xiaolongsya/pi-stm32-robot-dog/PCB_控制板pcb_2026-09-02.pdf

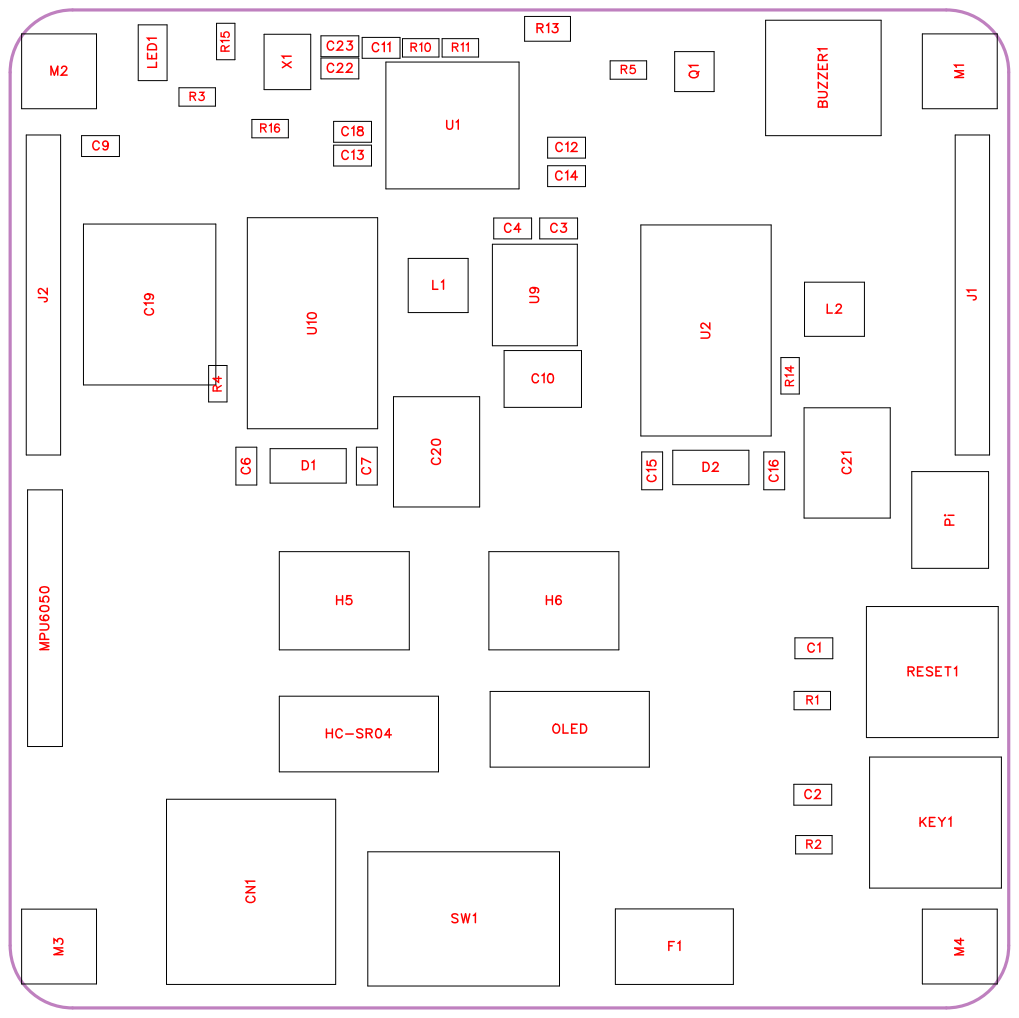
[picture p1: page 1]

No. | Quantity | Comment | Designator | Footprint | Value | Manufacturer Part | Manufacturer | Supplier Part | Supplier
1 | 1 | 2.7kHz | BUZZER1 | BUZ-TH_BD 9.0-P4.00-D0 .6-FD | 2.7kHz | QMB-09B-03 | 华能 | C96256 | LCSC
2 | 11 | 100nF | C1,C2,C6,C7,C9,C11,C12, C14,C15,C16,C18 | C0603 | 100nF | FCC0603B10 4K500CT | FOJAN(富捷) | C5137636 | LCSC
3 | 2 | 22uF | C3,C4 | C0603 | 22uF | HGC0603R5 226M100NT HJ | Chinocera(华 瓷) | C7432770 | LCSC
4 | 1 | 22uF | C10 | CAP-SMD_B D4.0-L4.3-W 4.3-FD_1 | 22uF | JVJ16V22M4 X5 | JIERR(捷而 瑞) | C46550398 | LCSC
5 | 1 | 10nF | C13 | C0603 | 10nF | FCC0603B10 3K500CT | FOJAN(富捷) | C5137477 | LCSC
6 | 1 | 470uF | C19 | CAP-SMD_B D10.0-L10.3-W10.3-LS11. 0 | 470uF | JVJ35V470M 10x10 | JIERR(捷而 瑞) | C46550413 | LCSC
7 | 2 | 220uF | C20,C21 | CAP-SMD_B D6.3-L6.6-W 6.6-LS7.3-FD | 220uF | MA25V220M 6X8 | JIERR(捷而 瑞) | C46550464 | LCSC
8 | 2 | 22pF | C22,C23 | C0603 | 22pF | CL10C220JB 8NNNC | SAMSUNG( 三星) | C1653 | LCSC
9 | 1 | XT30PW-M3 0.G.Y | CN1 | CONN-TH_X T30PW-M | | XT30PW-M3 0.G.Y | AMASS(艾迈 斯) | C431092 | LCSC
10 | 2 | SS54 | D1,D2 | SMA_L4.3-W 2.6-LS5.0-FD | | SS54 | R+O(宏嘉诚) | C7420369 | LCSC
11 | 1 | SMD2920-50 0-24 | F1 | F2920 | | SMD2920-50 0-24 | R+O(宏嘉诚) | C47753903 | LCSC
12 | 2 | 01.5.5.1.304. 03 | H5,H6 | HDR-TH_12 P-P2.54-V-M -R3-C4-S2.5 4 | | 01.5.5.1.304. 03 | RealRun(惟 赞) | C2937160 | LCSC
13 | 2 | LAIL-PHC2.5 4-4P-01-XH-L | HC-SR04,OLED | CONN-TH_L AIL-PHC2.54 -4P-01-XH-L | | LAIL-PHC2.5 4-4P-01-XH-L | 莱联 | C54905972 | LCSC
14 | 2 | 2.54-1*10P针 | J1,J2 | HDR-TH_10 P-P2.54-V-M -1 | | 2.54-1*10P针 | BOOMELE( 博穆精密) | C57369 | LCSC
15 | 2 | TS-1045AD-A8B3-D2 | KEY1,RESET1 | SW-SMD_Y UANDI_TS-1 045AD-A8B3 -D2 | | TS-1045AD-A8B3-D2 | Yuandi(元迪) | C2894745 | LCSC
16 | 2 | 3.3uH | L1,L2 | IND-SMD_L4 .0-W4.0 | 3.3uH | FHD4020S-3 R3MT | cjiang(长江微 电) | C602030 | LCSC
17 | 1 | GL0805UR0 1 | LED1 | LED0805-R-RD_RED | | GL0805UR0 1 | Guiguang lig ht(桂光光电) | C51933307 | LCSC
18 | 4 | M3螺钉孔 | M1,M2,M3,M4 | 螺钉孔
19 | 1 | 2.54-1*8 | MPU6050 | HDR-TH_8P-P2.54-V-M | | 2.54-1*8 | ZHOURI(洲 日) | C5156616 | LCSC

20 | 1 | HX 2.54mm-2P ZZ-MS | Pi | CONN-TH_2 P-P2.50_HX-2.54MM-2P-ZZ-MS | | HX 2.54mm-2P ZZ-MS | hanxia(韩下 ) | C7543455 | LCSC
21 | 1 | SS8050 | Q1 | SOT-23-3_L2 .9-W1.3-P1.9 0-LS2.4-BR | | SS8050 | R+O(宏嘉诚 ) | C7420370 | LCSC
22 | 4 | 10k | R1,R2,R10,R11 | R0603 | 10k | FRC0603J10 3 TS | FOJAN(富捷 ) | C2930027 | LCSC
23 | 4 | 1k | R3,R4,R5,R14 | R0603 | 1k | FRC0603F10 01TS | FOJAN(富捷 ) | C2907002 | LCSC
24 | 1 | 10k | R13 | R0805 | 10k | FRC0805F10 02TS | FOJAN(富捷 ) | C2907219 | LCSC
25 | 1 | 200k | R15 | R0603 | 200k | FRC0603F20 03TS | FOJAN(富捷 ) | C2907009 | LCSC
26 | 1 | 100k | R16 | R0603 | 100k | FRC0603F10 03TS | FOJAN(富捷 ) | C2906980 | LCSC
27 | 1 | HX KCD11-2P-R | SW1 | SW-TH_2P-L 15.0-W10.5-P5.00_KCD1 1-2P-R | | HX KCD11-2P-R | hanxia(韩下 ) | C6917318 | LCSC
28 | 1 | STM32G431 KBT6TR | U1 | LQFP-32_L7. 0-W7.0-P0.8 0-LS9.0-BL | | STM32G431 KBT6TR | ST(意法半导 体) | C5270317 | LCSC
29 | 2 | LM2596S-5.0 | U2,U10 | TO-263-5_L1 0.1-W8.7-P1. 70-LS14.4-B R | | LM2596S-5.0 | Slkor(萨科微 ) | C2980820 | LCSC
30 | 1 | AMS1117-3. 3 | U9 | SOT-223-4_L 6.5-W3.5-P2. 30-LS7.0-BR | | AMS1117-3. 3 | KEXIN(科信 ) | C369933 | LCSC
31 | 1 | 8MHz | X1 | CRYSTAL-S MD_4P-L3.2-W2.5-BL | 8MHz | X32258MSB 4SI | YXC(扬兴晶 振) | C2682774 | LCSC

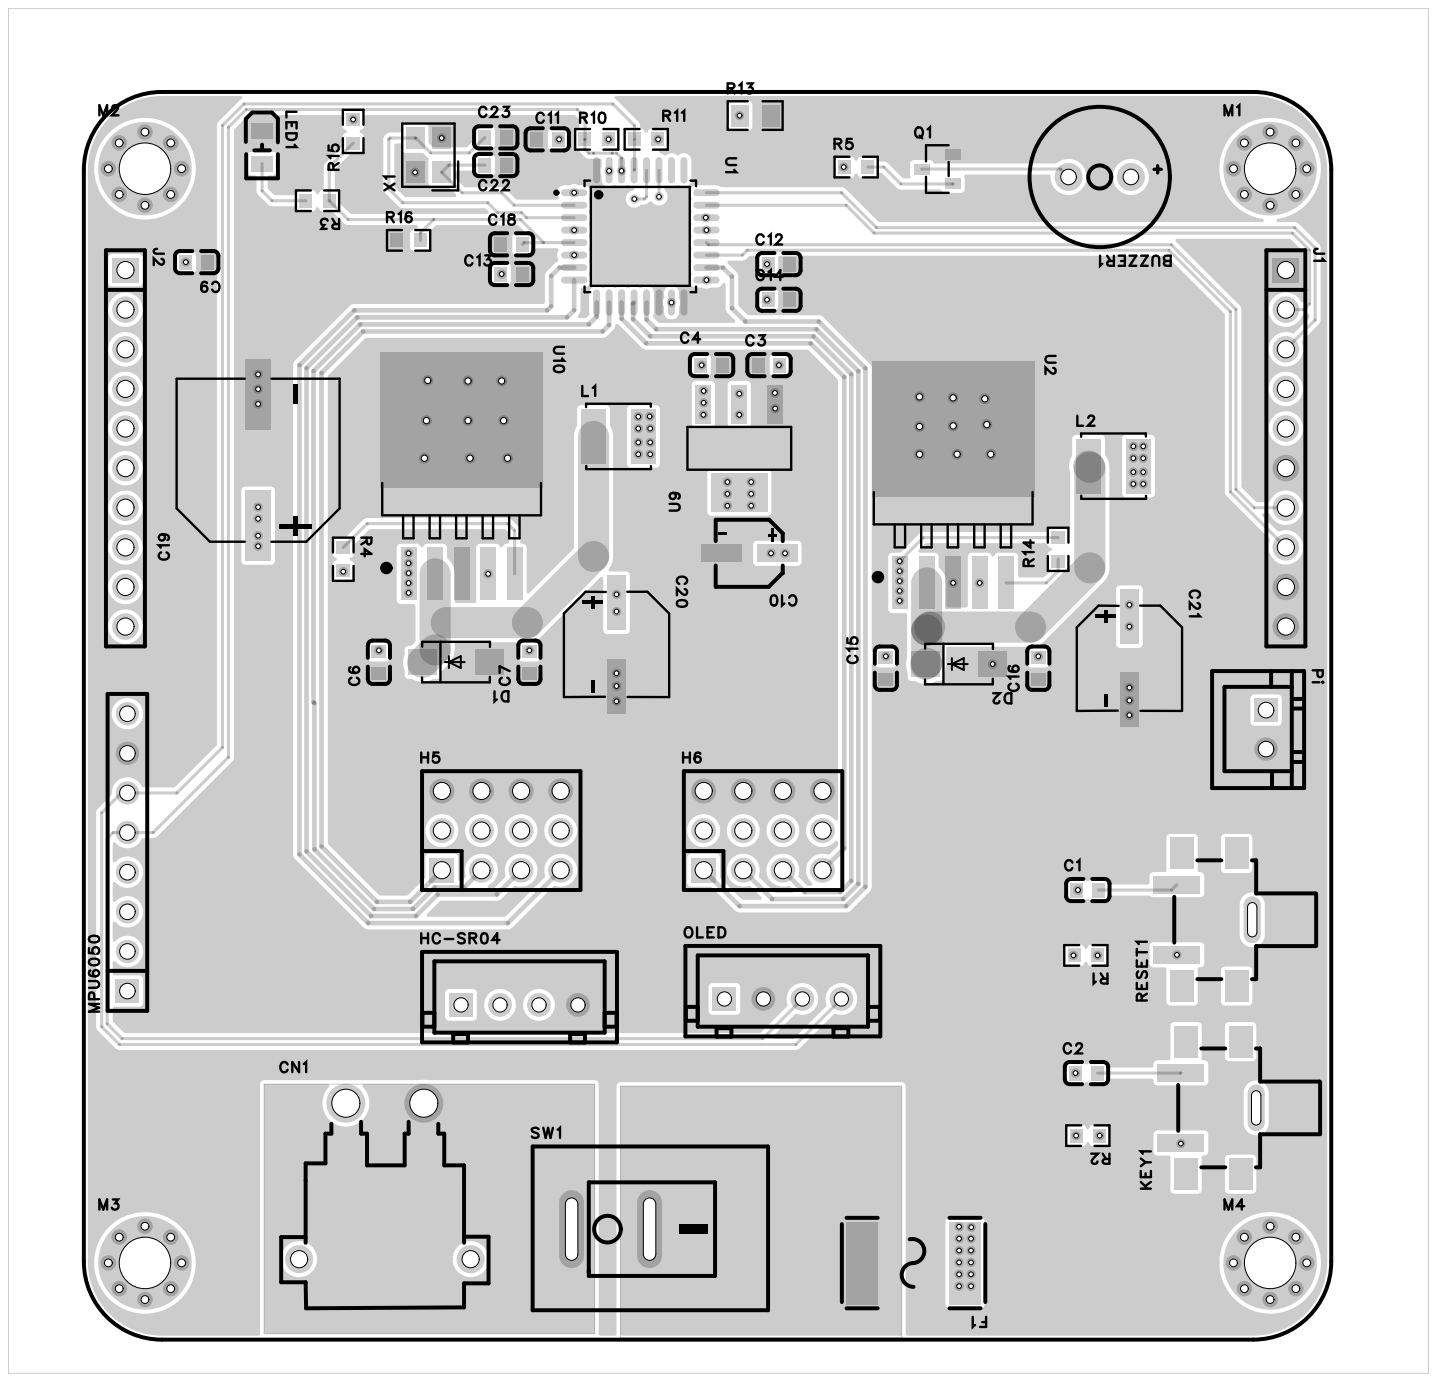
[picture p2: page 5]

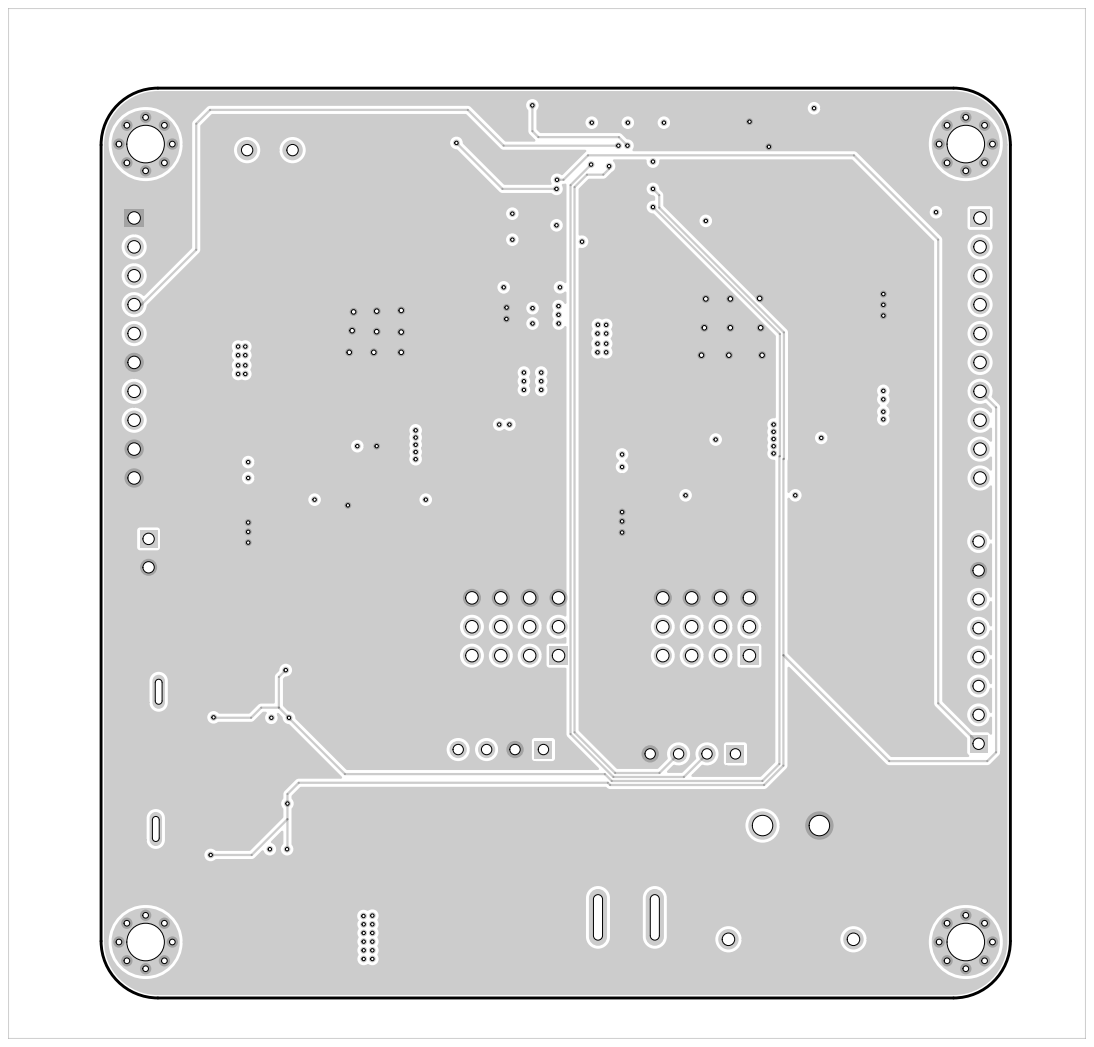
[picture p3: page 6]

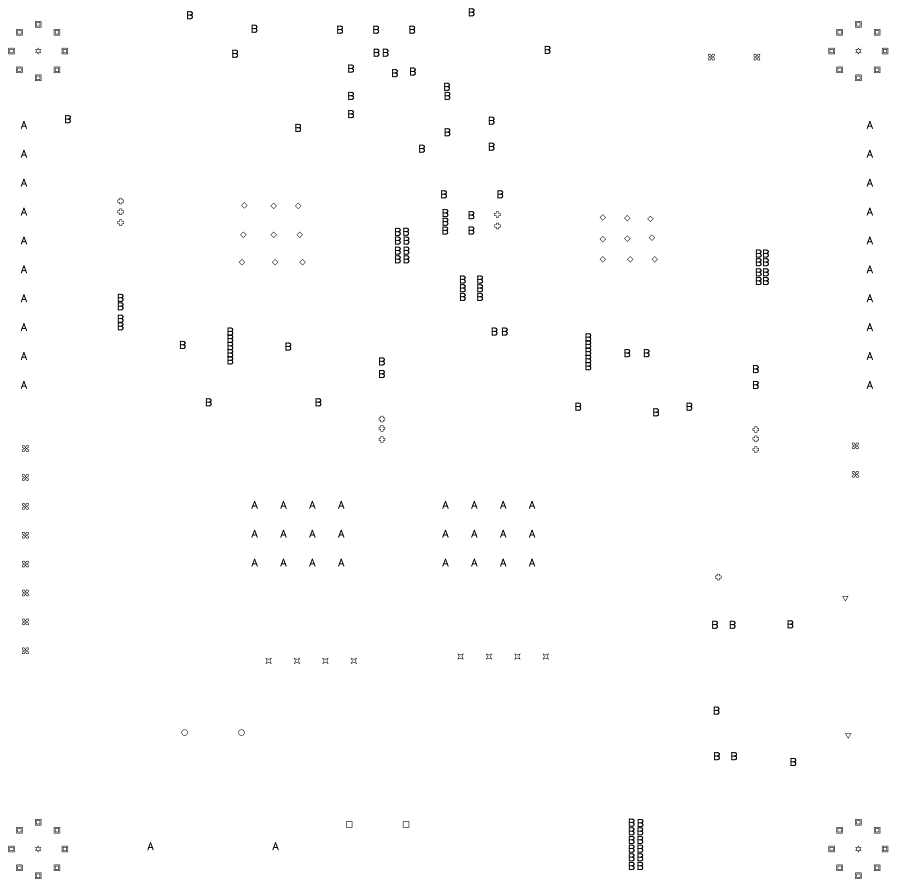
[picture p4: page 7]
