xiaolongsya/pi-stm32-robot-dog/BOM_Board2_控制板pcb_2026-09-02.xlsx

No. | Quantity | Comment | Designator | Footprint | Value | Manufacturer Part | Manufacturer | Supplier Part | Supplier
1 | 5 | 3A 5V LM2596S-5.0(UMW) | U2,U10 | TO-263-5_L10.1-W8.7-P1.70-LS14.4-BR | LM2596S-5.0(UMW) | LM2596S-5.0 | UMW(友台半导体) | C347421 | LCSC
2 | 5 | 8MHz 3225 晶振 | X1 | CRYSTAL-SMD_4P-L3.2-W2.5-BL | 8MHz | X32258MSB4SI | YXC(扬兴晶振) | C2682774 | LCSC
3 | 50 | NPN 三极管 SS8050 | Q1 | SOT-23-3_L2.9-W1.3-P1.90-LS2.4-BR | SS8050 | SS8050 | R+O(宏嘉诚) | C7420370 | LCSC
4 | 100 | 22pF 0603 瓷介电容 | C22,C23 | C0603 | 22pF | CL10C220JB8NNNC | SAMSUNG(三星) | C1653 | LCSC
5 | 15 | 220uF 25V 固态电容 6.3x7.7 | C20,C21 | CAP-SMD_BD6.3-L6.6-W6.6-LS7.3-FD | 220uF | MA25V220M6X8 | JIERR(捷而瑞) | C46550464 | LCSC
6 | 5 | 470uF 35V 10x10 铝电解 | C19 | CAP-SMD_BD10.0-L10.3-W10.3-LS11.0 | 470uF | JVJ35V470M10x10 | JIERR(捷而瑞) | C46550413 | LCSC
7 | 20 | 22uF 16V SMD 4x4.3 铝电解 | C10 | CAP-SMD_BD4.0-L4.3-W4.3-FD_1 | 22uF | JVJ16V22M4X5 | JIERR(捷而瑞) | C46550398 | LCSC
8 | 5 | TS-1045AD 6x6 触摸开关 | KEY1,RESET1 | SW-SMD_YUANDI_TS-1045AD-A8B3-D2 | TS-1045AD-A8B3-D2 | TS-1045AD-A8B3-D2 | Yuandi(元迪) | C2894745 | LCSC
9 | 10 | 2.54-1x10P 排针 | J1,J2 | HDR-TH_10P-P2.54-V-M-1 | 2.54-1x10P针 | 2.54-1*10P针 | BOOMELE(博穆精密) | C57369 | LCSC
10 | 10 | SS54 SMA 肖特基 40V 5A | D1,D2,D3 | SMA_L4.3-W2.6-LS5.0-FD | SS54 | SS54 | R+O(宏嘉诚) | C7420369 | LCSC
11 | 50 | HX 2.54-2P 母座 | Pi | CONN-TH_2P-P2.50_HX-2.54MM-2P-ZZ-MS | HX 2.54mm-2P ZZ-MS | HX 2.54mm-2P ZZ-MS | hanxia(韩下) | C7543455 | LCSC
12 | 1 | XT30PW-M30 公头 电池座 | CN1 | CONN-TH_XT30PW-M | XT30PW-M30.G.Y | XT30PW-M30.G.Y | AMASS(艾迈斯) | C431092 | LCSC
13 | 20 | 22uF 0603 MLCC 陶瓷 | C3,C4 | C0603 | 22uF | HGC0603R5226M100NTHJ | Chinocera(华瓷) | C7432770 | LCSC
14 | 100 | 200kΩ 0603 厚膜电阻 | R15 | R0603 | 200kΩ | FRC0603F2003TS | FOJAN(富捷) | C2907009 | LCSC
15 | 5 | QMB-09B-03 无源蜂鸣器 | BUZZER1 | BUZ-TH_BD9.0-P4.00-D0.6-FD | 2.7kHz | QMB-09B-03 | 华能 | C96256 | LCSC
16 | 10 | AMS1117-3.3 SOT-223 LDO | U9 | SOT-223-4_L6.5-W3.5-P2.30-LS7.0-BR | AMS1117-3.3 | AMS1117-3.3 | KEXIN(科信) | C369933 | LCSC
17 | 1 | STM32G431KBT6TR LQFP-32 | U1 | LQFP-32_L7.0-W7.0-P0.80-LS9.0-BL | STM32G431KBT6TR | STM32G431KBT6TR | ST(意法半导体) | C5270317 | LCSC
18 | 100 | 10kΩ 0805 厚膜电阻 | R13 | R0805 | 10kΩ | FRC0805F1002TS | FOJAN(富捷) | C2907219 | LCSC
19 | 10 | 2.54-1x8 排针 | MPU6050 | HDR-TH_8P-P2.54-V-M | 2.54-1*8 | 2.54-1*8 | ZHOURI(洲日) | C5156616 | LCSC
20 | 50 | 10nF 0603 瓷介电容 | C13 | C0603 | 10nF | FCC0603B103K500CT | FOJAN(富捷) | C5137477 | LCSC
21 | 50 | 100nF 0603 瓷介电容 | C1,C2,C6,C7,C9,C11,C12,C14,C15,C16,C18 | C0603 | 100nF | FCC0603B104K500CT | FOJAN(富捷) | C5137636 | LCSC
