xiaolongsya/pi-stm32-robot-dog/STM32项目/MachineDog_V1/Core/Src/main.c

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
/* Includes ------------------------------------------------------------------*/
#include "main.h"
#include "i2c.h"
#include "tim.h"
#include "usart.h"
#include "gpio.h"

/* USER CODE BEGIN Includes */
#include <stdio.h>
/* USER CODE END Includes */


void SystemClock_Config(void);
/**
  * @brief  The application entry point.
  * @retval int
  */
int main(void)
{
  HAL_Init();
  SystemClock_Config();

  MX_GPIO_Init();
  MX_I2C1_Init();
  MX_TIM1_Init();
  MX_TIM2_Init();
  MX_TIM3_Init();
  MX_TIM17_Init();
  MX_USART1_UART_Init();

  /* USER CODE BEGIN 2 */
  /* ⚠️ CubeMX 不自动调 HAL_TIM_PWM_MspPostInit → 必须手动启动 HAL_TIM_PWM_Start */
  HAL_TIM_PWM_Start(&htim1, TIM_CHANNEL_1);    /* PA8  = TIM1_CH1 = servo7 */
  HAL_TIM_PWM_Start(&htim2, TIM_CHANNEL_1);    /* PA5  = TIM2_CH1 = servo3 */
  HAL_TIM_PWM_Start(&htim2, TIM_CHANNEL_3);    /* PA2  = TIM2_CH3 = servo0 */
  HAL_TIM_PWM_Start(&htim2, TIM_CHANNEL_4);    /* PA3  = TIM2_CH4 = servo1 */
  HAL_TIM_PWM_Start(&htim3, TIM_CHANNEL_1);    /* PA6  = TIM3_CH1 = servo4 */
  HAL_TIM_PWM_Start(&htim3, TIM_CHANNEL_2);    /* PA4  = TIM3_CH2 = servo2 */
  HAL_TIM_PWM_Start(&htim3, TIM_CHANNEL_3);    /* PB0  = TIM3_CH3 = servo6 */
  HAL_TIM_PWM_Start(&htim17, TIM_CHANNEL_1);   /* PA7  = TIM17_CH1 = servo5 */
  /* USER CODE END 2 */

  while (1)
  {
    /* USER CODE BEGIN 3 */
    /* 8 路舵机来回摆动:右 → 中 → 左 → 中 (各 800ms) */

    /* 右侧 2000 (2.0ms = +90°) */
    __HAL_TIM_SET_COMPARE(&htim1, TIM_CHANNEL_1, 2000);
    __HAL_TIM_SET_COMPARE(&htim2, TIM_CHANNEL_1, 2000);
    __HAL_TIM_SET_COMPARE(&htim2, TIM_CHANNEL_3, 2000);
    __HAL_TIM_SET_COMPARE(&htim2, TIM_CHANNEL_4, 2000);
    __HAL_TIM_SET_COMPARE(&htim3, TIM_CHANNEL_1, 2000);
    __HAL_TIM_SET_COMPARE(&htim3, TIM_CHANNEL_2, 2000);
    __HAL_TIM_SET_COMPARE(&htim3, TIM_CHANNEL_3, 2000);
    __HAL_TIM_SET_COMPARE(&htim17, TIM_CHANNEL_1, 2000);
    HAL_Delay(800);

    /* 中位 1500 */
    __HAL_TIM_SET_COMPARE(&htim1, TIM_CHANNEL_1, 1500);
    __HAL_TIM_SET_COMPARE(&htim2, TIM_CHANNEL_1, 1500);
    __HAL_TIM_SET_COMPARE(&htim2, TIM_CHANNEL_3, 1500);
    __HAL_TIM_SET_COMPARE(&htim2, TIM_CHANNEL_4, 1500);
    __HAL_TIM_SET_COMPARE(&htim3, TIM_CHANNEL_1, 1500);
    __HAL_TIM_SET_COMPARE(&htim3, TIM_CHANNEL_2, 1500);
    __HAL_TIM_SET_COMPARE(&htim3, TIM_CHANNEL_3, 1500);
    __HAL_TIM_SET_COMPARE(&htim17, TIM_CHANNEL_1, 1500);
    HAL_Delay(800);

    /* 左侧 1000 */
    __HAL_TIM_SET_COMPARE(&htim1, TIM_CHANNEL_1, 1000);
    __HAL_TIM_SET_COMPARE(&htim2, TIM_CHANNEL_1, 1000);
    __HAL_TIM_SET_COMPARE(&htim2, TIM_CHANNEL_3, 1000);
    __HAL_TIM_SET_COMPARE(&htim2, TIM_CHANNEL_4, 1000);
    __HAL_TIM_SET_COMPARE(&htim3, TIM_CHANNEL_1, 1000);
    __HAL_TIM_SET_COMPARE(&htim3, TIM_CHANNEL_2, 1000);
    __HAL_TIM_SET_COMPARE(&htim3, TIM_CHANNEL_3, 1000);
    __HAL_TIM_SET_COMPARE(&htim17, TIM_CHANNEL_1, 1000);
    HAL_Delay(800);

    /* 再回中位 1500 */
    __HAL_TIM_SET_COMPARE(&htim1, TIM_CHANNEL_1, 1500);
    __HAL_TIM_SET_COMPARE(&htim2, TIM_CHANNEL_1, 1500);
    __HAL_TIM_SET_COMPARE(&htim2, TIM_CHANNEL_3, 1500);
    __HAL_TIM_SET_COMPARE(&htim2, TIM_CHANNEL_4, 1500);
    __HAL_TIM_SET_COMPARE(&htim3, TIM_CHANNEL_1, 1500);
    __HAL_TIM_SET_COMPARE(&htim3, TIM_CHANNEL_2, 1500);
    __HAL_TIM_SET_COMPARE(&htim3, TIM_CHANNEL_3, 1500);
    __HAL_TIM_SET_COMPARE(&htim17, TIM_CHANNEL_1, 1500);
    HAL_Delay(800);
    /* USER CODE END 3 */
  }
}

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
void Error_Handler(void)
{
  __disable_irq();
  while (1) {}
}
#ifdef USE_FULL_ASSERT
void assert_failed(uint8_t *file, uint32_t line) {}
#endif
