xiaolongsya/pi-stm32-robot-dog/STM32项目/MachineDog_V1/MachineDog_V1.ioc

Mcu.UserName=STM32G431KBTx
PA10.Signal=USART1_RX
PA13.Signal=SYS_JTMS-SWDIO
PA14.Signal=SYS_JTCK-SWCLK
PA15.Signal=I2C1_SCL
PA2.Signal=S_TIM2_CH3
PA3.Signal=S_TIM2_CH4
PA4.Signal=S_TIM3_CH2
PA5.Signal=S_TIM2_CH1
PA6.Signal=S_TIM3_CH1
PA7.Signal=S_TIM17_CH1
PA8.Signal=S_TIM1_CH1
PA9.Signal=USART1_TX
PB0.Signal=S_TIM3_CH3
PB7.Signal=I2C1_SDA
PF0-OSC_IN.Signal=RCC_OSC_IN
PF1-OSC_OUT.Signal=RCC_OSC_OUT
