xiaolongsya/pi-stm32-robot-dog/(commit log)

2026-09-01 Initial commit: v3 schematic + 80x80 PCB complete
    - STM32G431KBT6 (LQFP-32, 0.8mm pitch) + Pi Zero3 dual MCU
    - 52 components on 4-layer 80x80mm PCB
    - 8 MG90S servos driven directly from STM32 (no PCA9685)
    - 2x LM2596 + AMS1117 power (split servo + logic rails)
    - MPU6050 IMU + SSD1306 OLED + HC-SR04 ultrasonic
    - Battery voltage monitoring (R15/R16 divider to PA8 ADC)
    - Ship-type SW1 switch in battery main line
    - USB-C removed (no charging, no use)
    - MIT license, English README for open-source release
    - Repo: https://github.com/xiaolongsya/pi-stm32-robot-dog
2026-09-01 修正:Git 提交消息用中文(不是说话)
2026-09-01 gitignore 排除 AI 协作文档(CLAUDE.md / KICKOFF_PROMPT.md)和测试数据,只留项目产物
2026-09-02 v1 PCB 投板前审查完成(3 轮 ultracode):5 个 critical 全部修复
    - 修 LM2596 ON/OFF 接错(整板不上电):删 R4/R14,U2.5/U10.5 直连 GND
    - 修 I2C 引脚分配:SDA→PB7,SCL→PA15,R10/R11 改 4.7kΩ
    - 修 NRST/PA1 反接:两网对调
    - 修 GND 补接:C1/C2/RESET1/KEY1 4 pad 接 GND
    - 加 5V 测试点 TP1 / 3V3 测试点 TP2
    - R3 改 5V LED 指示灯
    - SW1 网格名改 BAT_IN / BAT_SWITCH
    新增:机器狗v1控制板_投板前审查报告.md
    新增数据手册:SS54 / SS8050 / 电感(33uH 5.9A 选型参考)
    0 critical / high 残留,可投板。
    [BOM_Board2_控制板pcb_2026-09-02.xlsx, PickAndPlace_控制板pcb_2026_09_02.xlsx, 机器狗v1_控制板_20260902_003336-立创_20260902.xls]
2026-09-02 v1 PCB 投板前最终版:D3 续流修复 + 文件清理 + 数据手册补 GSM1040
    - 修 BUZ-06:D3 续流二极管接法(并联,阴极接 3V3,阳极接 BUZZER_OUT)
    - 用户首次改 PCB 时 D3 串联在蜂鸣器和 Q1 之间(失效),AI 综评发现并修正
    - 网表 BUZZER_OUT = BUZZER1.2 + D3.1 + Q1.3(3 pin 同网)
    - 删 3 个过时网表(*2026-09-01.tel / *2026-09-02.tel x2)+ 过时立创 xls
    - 删过时数据手册/电感.pdf + 电感.txt,补 GSM1040-330-M.pdf(与 BOM 对应)
    - 新增数据手册/ams.txt + 数据手册/lm.txt(用户 OCR 提取)
    - 审查报告加 D3 修复 + 综评流程改进 + 文件清理说明(第 9-11 节)
    D3 接法验证(综评):
    - D3.2(阴极)接 3V3,D3.1(阳极)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
    [BOM_Board2_控制板pcb_2026-09-02.xlsx, PickAndPlace_控制板pcb_2026_09_02.xlsx, 机器狗v1_控制板_20260902_003336-立创_20260902.xls]
2026-09-02 BOM 改成嘉立创购物车实际下单清单(21 项)
    按用户购物车内容改 BOM_Board2_控制板pcb_2026-09-02.xlsx:
    - 保留 21 项(每项按购物车实际购买数量,含备件)
    - 删 BOM 中不在购物车的元件(R1/R2/R3/R5/R10/R11/R16 库存已有;C1/C6/C7 等 100nF 部分库存)
    - 删 HC-SR04/OLED 4P 母座 / L1/L2 33uH 电感 / LED1 / M1-M4 螺丝孔 / SW1 船型开关 / TP1/TP2 测试点
    - 不含 12P 排针(用户单独买)+ 不含 F1(用户购物车漏了,待用户拍板)
    - LM2596S-5.0 改用 UMW C347421(原 Slkor C2980820)
    ⚠️ F1 SMD2920-500-24 漏在购物车外,PCB 需 F1 保护,待用户拍板补下单。
    ⚠️ 12P 排针(H5/H6 舵机)用户单独买,不在 BOM。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
    [BOM_Board2_控制板pcb_2026-09-02.xlsx]
2026-09-07 更新 README 进度表 + 加 BOM 对照库存清单
    - README: v1 Fabrication → ✅, 新增'v1 板子当前状态'小节(旧板调试退役/新板焊接中,固件进度指向 stm32项目/main.c)
    - 加 BOM 采购清单(对照元器件库存,2026-09-02 整理)
    CLAUDE.md 已同步精简+加入 STM32 固件踩坑教训(本仓库不提交 CLAUDE.md,gitignore 覆盖)
2026-09-09 v1 PCB 8路舵机驱动验证(里程碑)
    - SYSCLK=168MHz (HSE 8MHz × PLL ×42 / 2)
    - 8路PWM舵机驱动: TIM1/2/3/17 全通道映射 PA2/3/4/5/6/7/8/PB0
    - 50Hz 周期,中位 Pulse=1500 (1.5ms)
    - 修复 TIM17 CubeMX 漏配 PulseNoDither_1 (tim.c sConfigOC.Pulse=0→1500)
    - 修复 CubeMX 6.x 不自动调 HAL_TIM_MspPostInit (main.c 手动调 8 路 HAL_TIM_PWM_Start)
    - I2C1 配 PA15(SCL)/PB7(SDA) AF4,总线下游设备扫描工作
    - USART1 配 PA9(TX)/PA10(RX) (Pi 通信预备)
    - 8 路舵机实际空载测试 7-8 个同时运行稳定,抖一次消失
    排除 .launch 调试配置(Debug 配置打开工程时重新生成)。
    STM32项目/ 移动到机器狗/ 下,.gitignore 增加 STM32 编译产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
    [MachineDog_V1.ioc, main.c]
