xiaolongsya/pi-stm32-robot-dog/(notices)

Notices in the files:
README.md:
License: MIT
